MeeBlip/meeblip-anode/README.md

meeblip-anode
=============

Meeblip anode hybrid MIDI synthesizer
