MeeBlip/meeblip-anode/Hardware/Anode core DAC schematic.pdf

## VCC

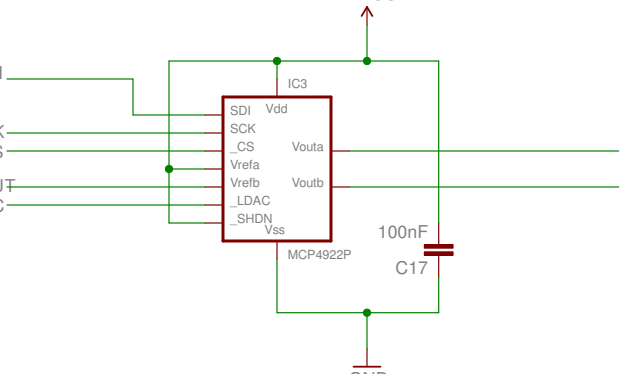
[picture p1: figure]
Vdd; Vss; Vouta; Voutb; SCK; SDI; _LDAC _SHDN; Vrefa Vrefb; MCP4922P

## GND

## DACA

## DACB

CS

## LDAC

## SCK

## MOSI

## VCF_OUTPUT

# MeeBlip Anik V1.30 - DAC

# J. Grahame | October 9, 2013 | meeblip.com
