MeeBlip/meeblip-anode/Hardware/Anode core main schematic.pdf

## Potentiometers

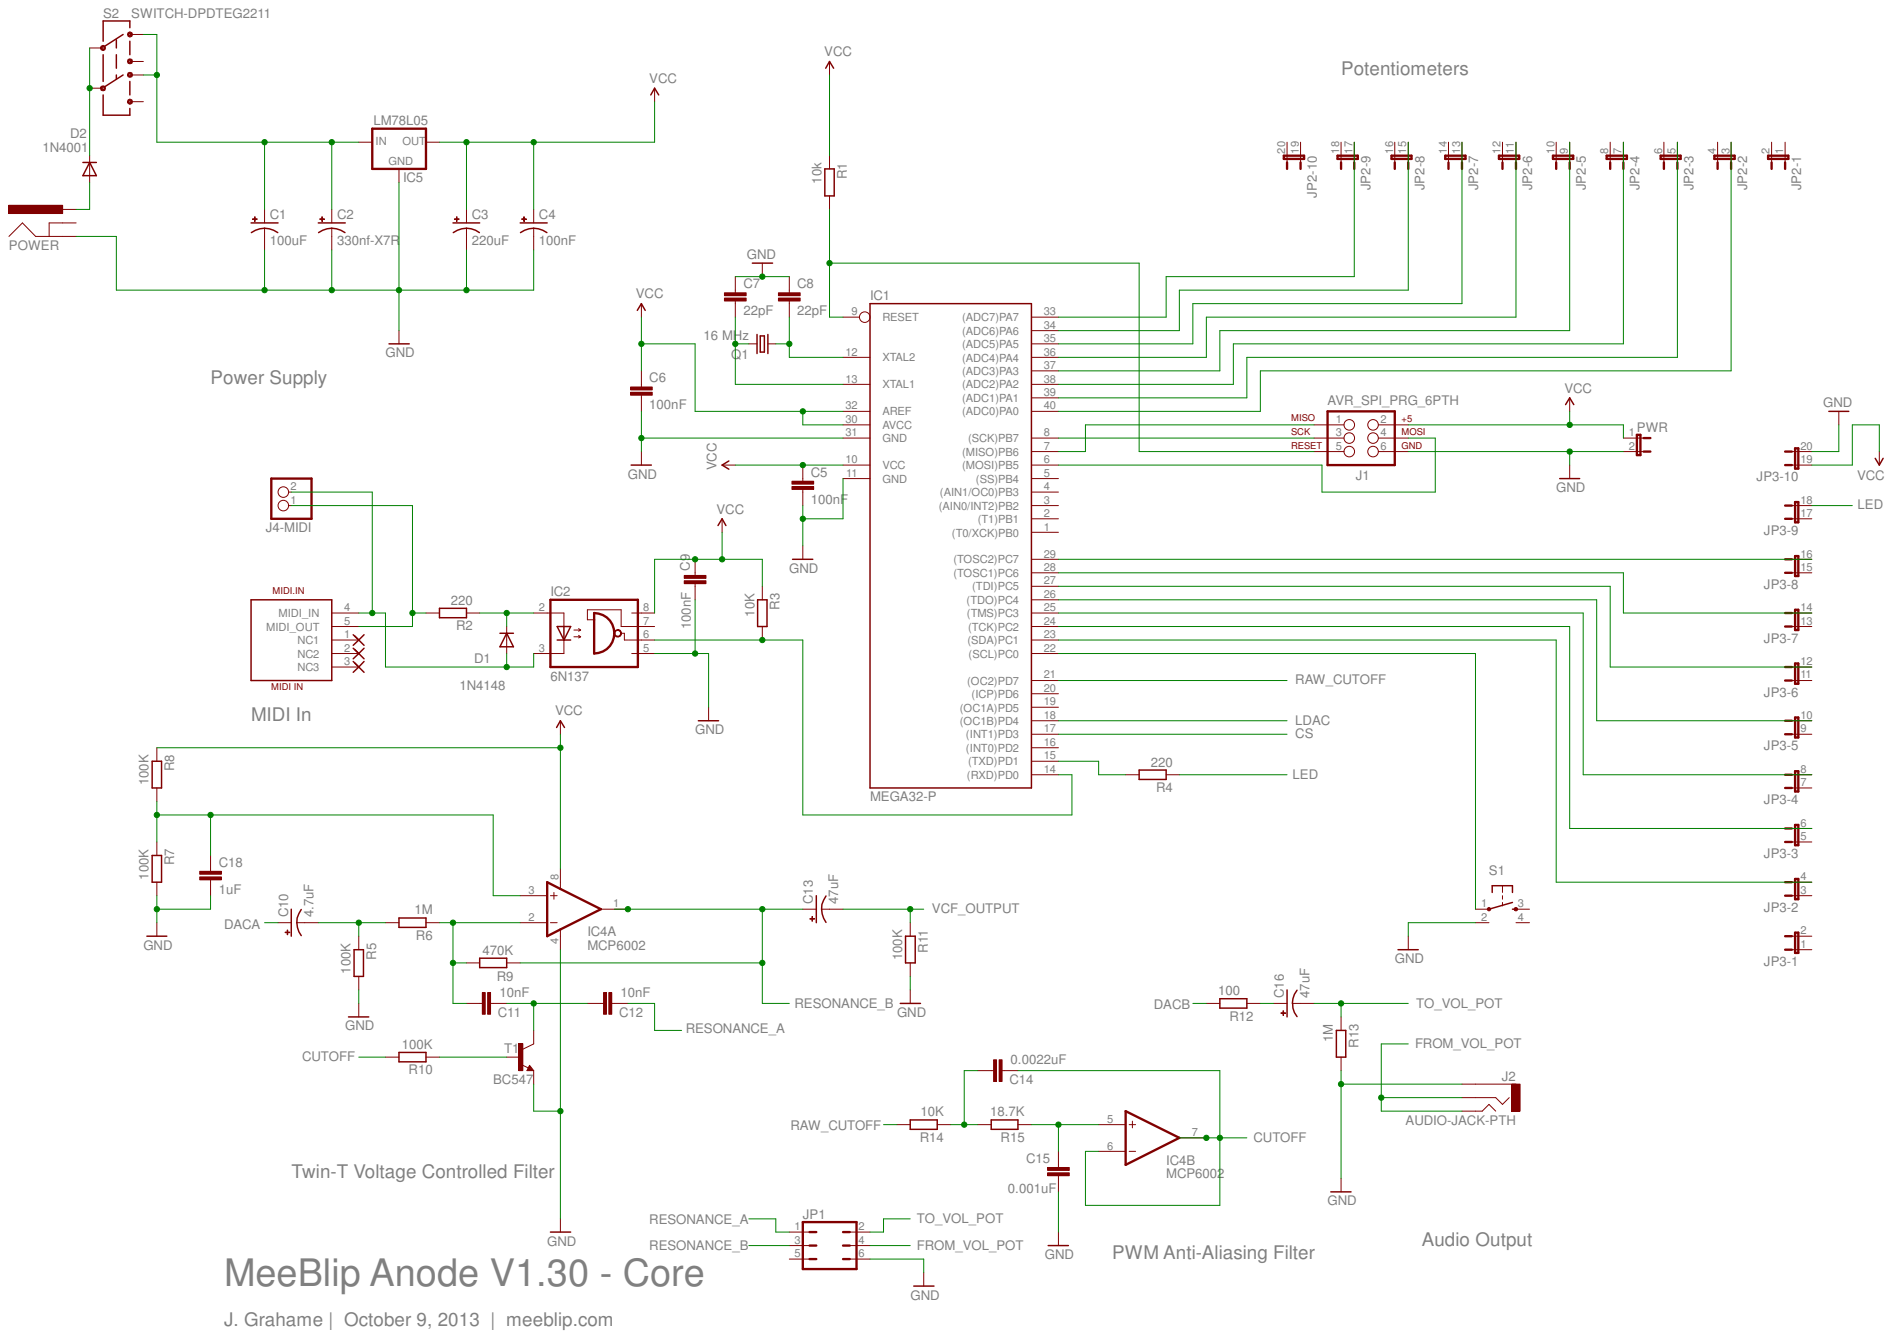
[picture p2: page 1]

GND 31 AVCC 30 AREF 32 | 1 2 3 4 5 6

SCK | MOSI

Twin-T Voltage Controlled Filter

J. Grahame | October 9, 2013 | meeblip.com
