MeeBlip/meeblip-anode/Hardware/Anode top schematic.pdf

## Potentiometers (10K Linear)

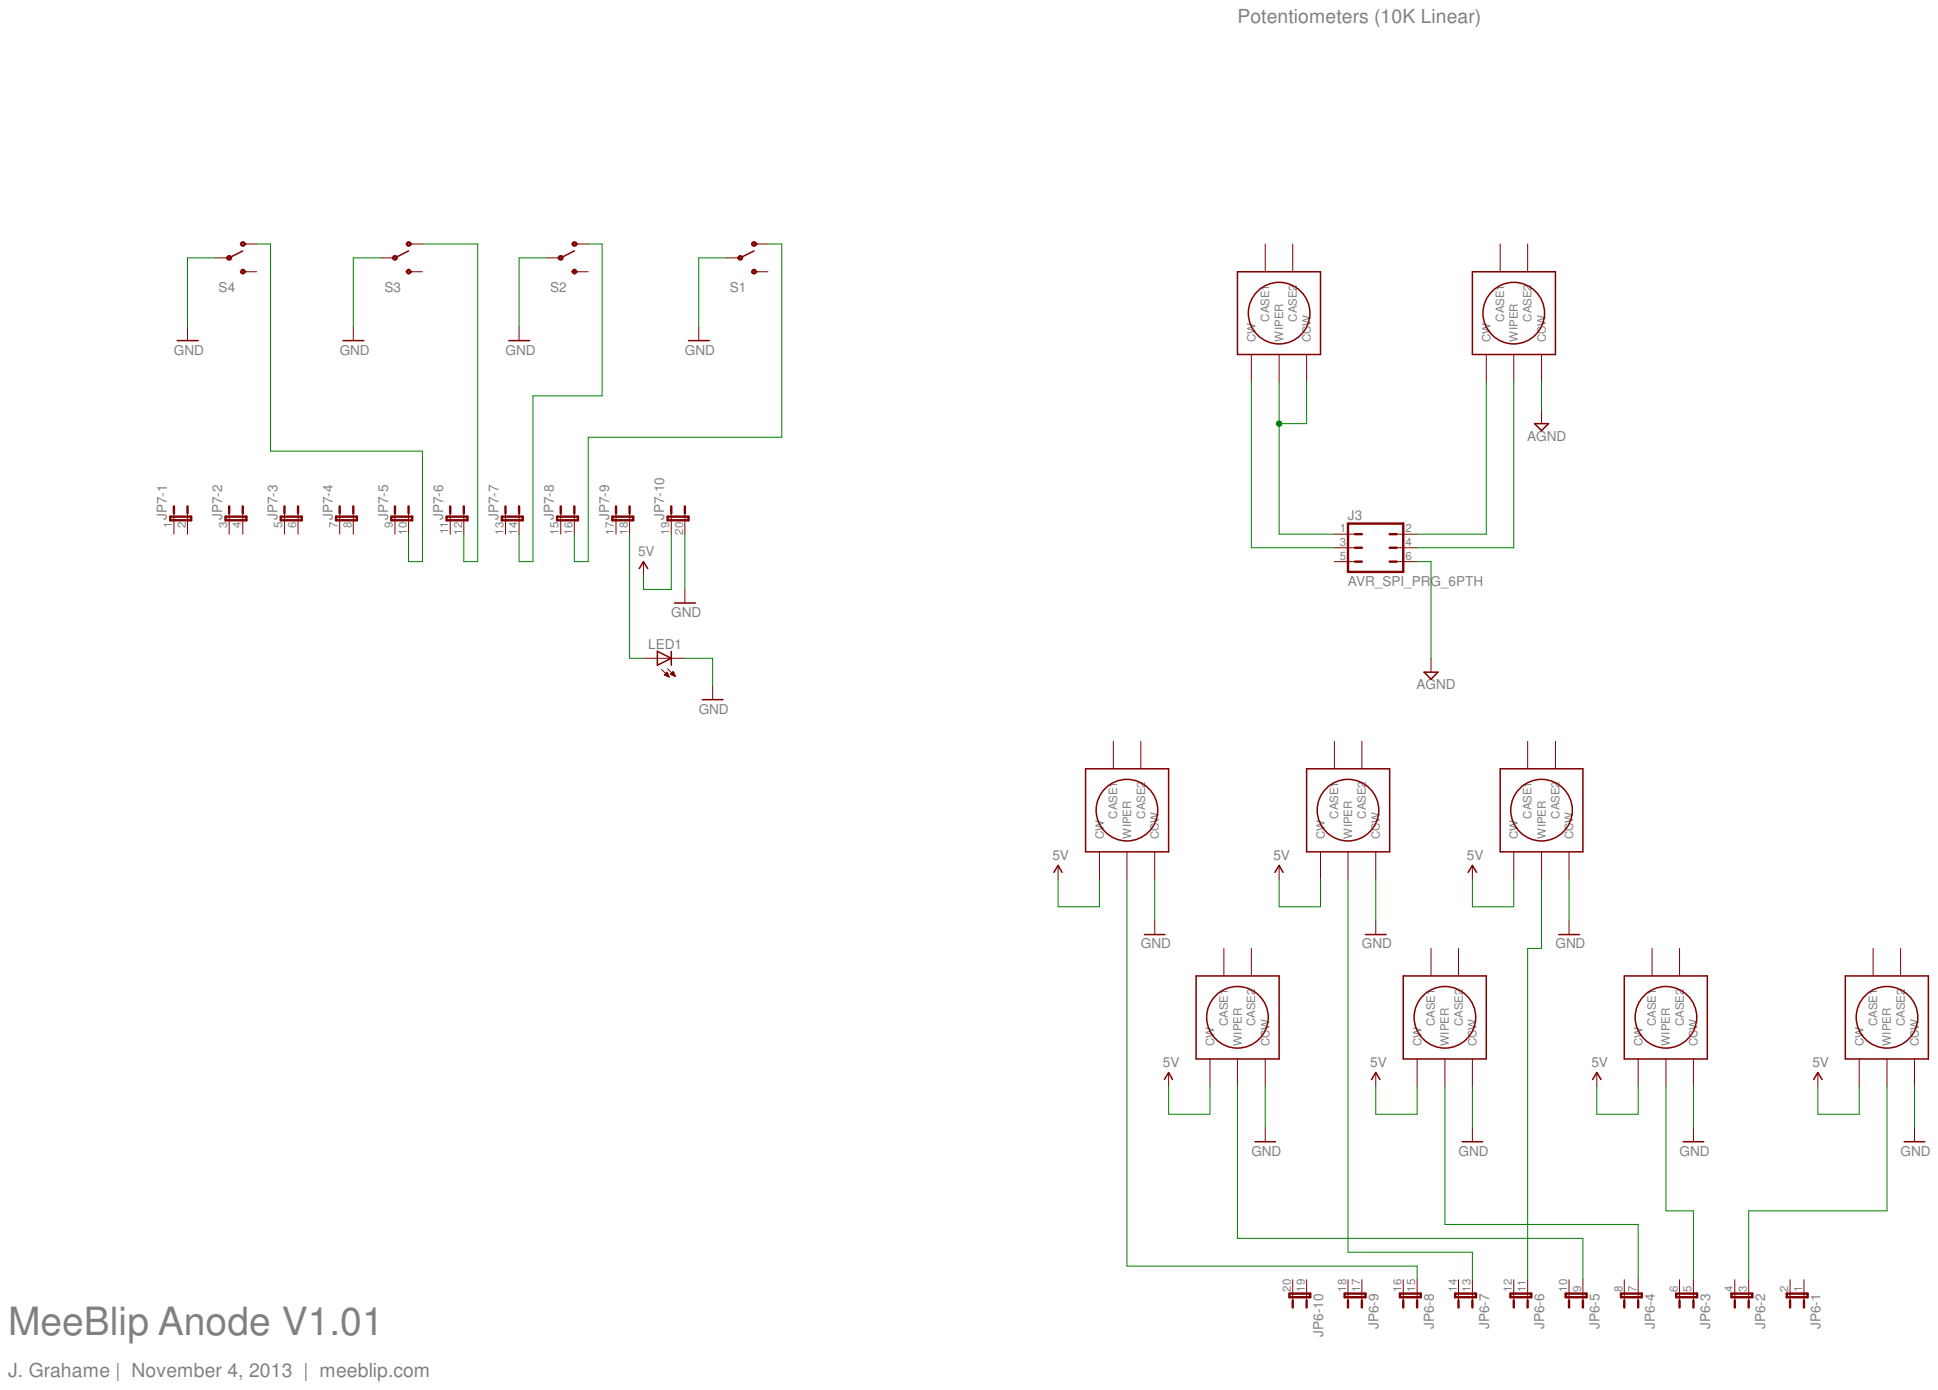
[picture p3: page 1]
AVR_SPI_PRG_6PTH; GND; AGND; CASE1; CASE2; WIPER; CCW; LED1; MeeBlip Anode V1.01

J. Grahame | November 4, 2013 | meeblip.com
