MeeBlip/meeblip-anode/(commit log)

2014-05-22 Version 1.01
    Initial hardware release
    [Anode core.brd, Anode core.sch, Anode top.brd, Anode top.sch]
2014-05-23 Version 1.10
    Improved lowpass filter code.
